supergivi/humidifier/README.md

# humidifier
Powerfull home humidifier with 30 liters tank  

[Фотки](https://github.com/supergivi/humidifier/tree/master/images)

Мне нужна нормальная влажность зимой. Иначе неприятно. И еще я люблю свежий воздух. Я перепробовал 3 разных увлажнителя за последние лет пять и с уверенностью заявляю, зимой в квартире которая нормально проветривается, невозможно удержать нормальную влажность с помщью того барахла, которое испаряет 350 мл в час. Не справляются ни один такой, ни вдвоем. Либо дома душно и влажность подбирается к приемлемым значениям, либо воздух свежий и влажность 9–15 процентов.
Решил сделать сам. Большой. Мощный. Емкий. С выносным датчиком влажности.
На алиэкспресс купил десятиголовый ультразвуковой излучатель с блоком питания.

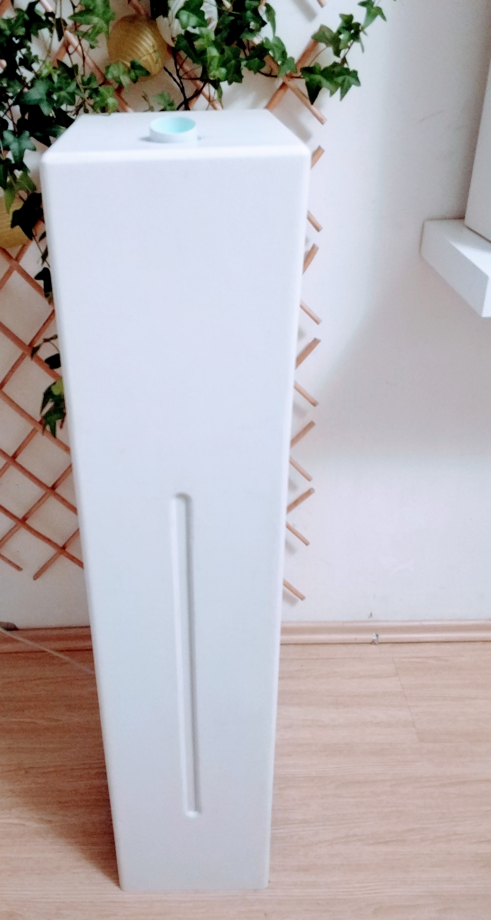
[picture p1: images/obchiy.jpg]
HUM


Корпус сделал из фанеры, с двумя герметичными камерами, соедененными пятисантиметровой канализационной трубой. Верхняя камера для излучателя, а нижняя для хранения воды. В самом низу, под нижней камерой расположил всю электронную начинку. А сверху верхней камеры провертел дыру для выхода пара. Все, что может касаться воды покрыл гидроизоляцией, подходящей для стоячей воды.
Вода заливается через через дырку для пара. Излучатель должен находиться под водой, поэтому труба выступает из дна верхней камеры на 7 сантиметров. Когда мы наливаем воду в увлажнитель, вся лишняя вода уходит в нижнюю камеру. Для контроля количества воды в нижней камере я сделал узкое, длиной во всю камеру смотровое окно из оргстекла. Обьем нижней камеры 30 литров. 

Со смотровым окном случился конфуз. Стекло, которое я применил, через пару дней использования решило потрескаться и стало пропускать воду. Выломал его нафиг, и на его место вклеил кусок пластика от кабель–канала. Стало совершенно неюзабельно в плане контроля количества воды, но за то герметично)

Для детектирования уровня воды в верхней камере использовал датчик уровня воды. При недостаточном уровне, насос перекачивает воду из нижней камеры в верхнюю. 
Датчик влажности сделал выносным. Болтается на двухметровом проводе.
В качестве платы управления использовал ардуину. Она запитана от блока питания, выломанного из старой зарядки на 12 вольт. Вентилятор и насос управляются ардуиной через драйвер, с помощью которого я могу плавно менять им обороты. Излучатель питается через свой 48 вольтовый блок питания. Управляю им тоже через ардуину, с помощью реле.
Почитав всякой литературы, понял, что опираться на относительную влажность будет не совсем правильно, потому что для 19 градусов оптимально больше 50%, а для 25 уже около 40%. А вот абсолютная влажность подходит хорошо. Остановился на 9 граммах на кубометр. Это 39% при 25 градусах, и 55% при 19 градусах. Очень похоже на кривую оптимальной влажности для разных температур, которую я нарыл в интернетах. Решил пересчитывать относительную влажность и температуру, приходящие с датчика в абсолютную влажность и управлять прибором исходя из нее.
Увлажнитель при необходимости готов испарить более полутора литров в час, и теперь невзирая на открытые форточки и погоду за окном у меня всегда оптимальная влажность) Вот! Ну и надо понимать, что это концепт. Когда я начинал его делать, у меня не было уверенности в том, что я хочу увидеть в итоге.
