supergivi/humidifier/images/blok-shema.jpg

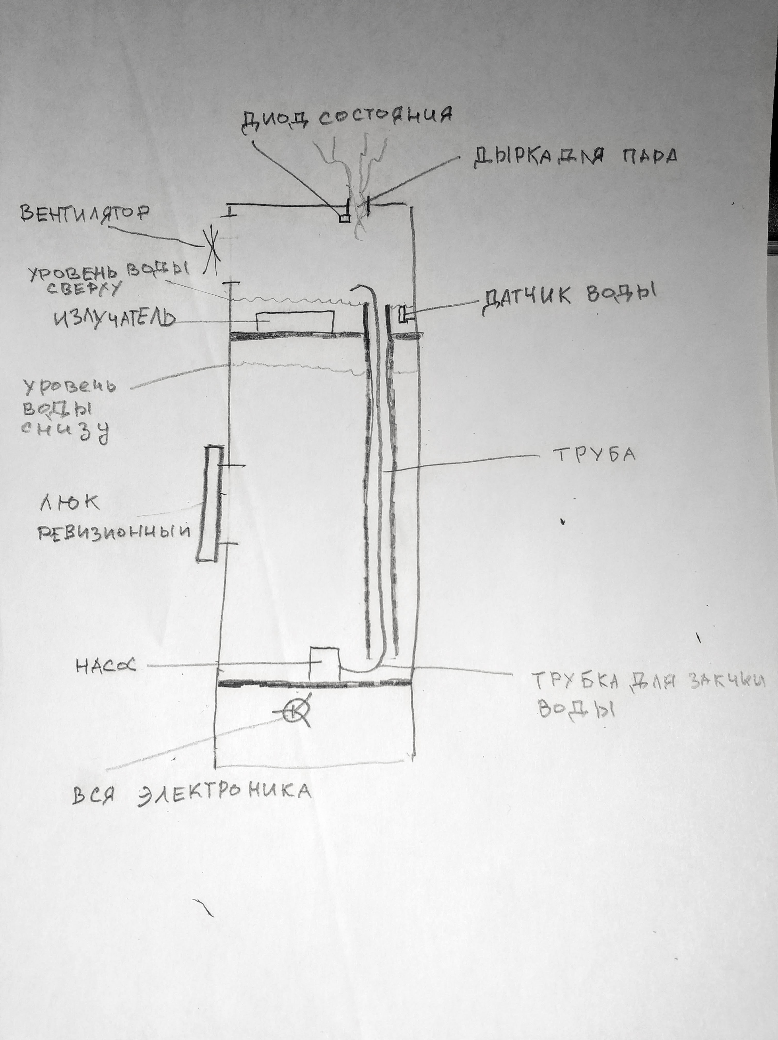
images/blok-shema.jpg
