supergivi/humidifier/images/datchik.jpg

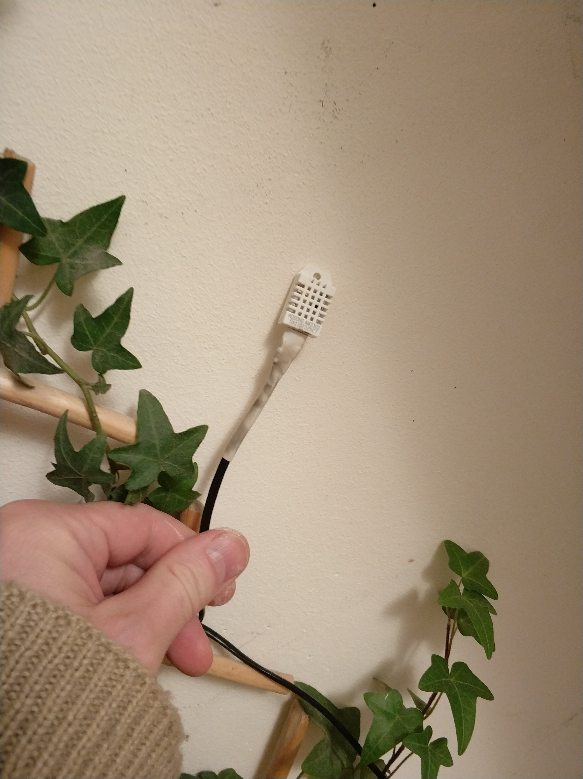
images/datchik.jpg
