supergivi/humidifier/images/dno_nijney_kamery.jpg

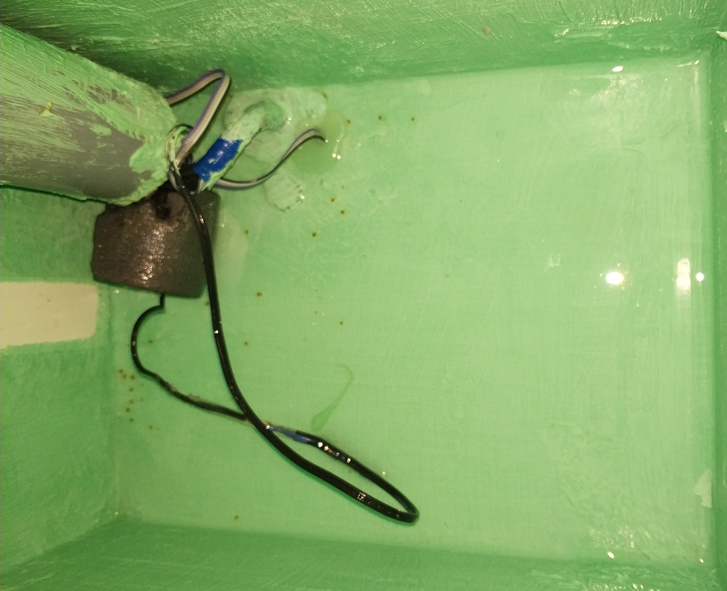
images/dno_nijney_kamery.jpg
