supergivi/humidifier/images/elektronika.jpg

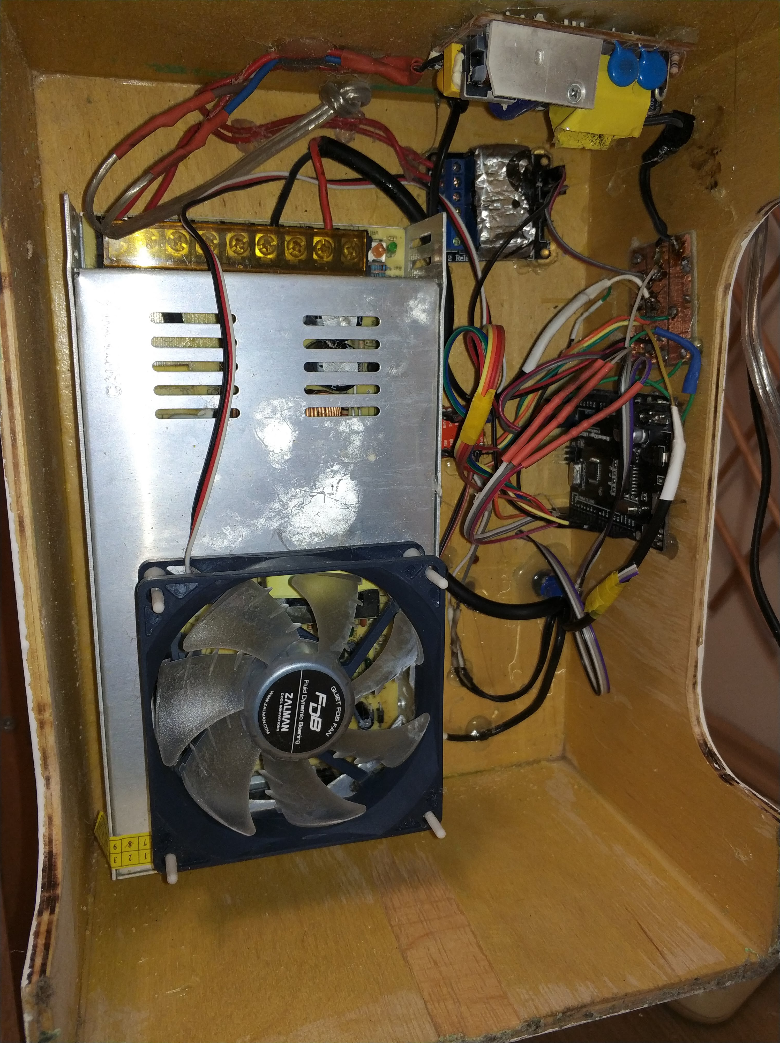
images/elektronika.jpg
