supergivi/humidifier/images/glaz2.jpg

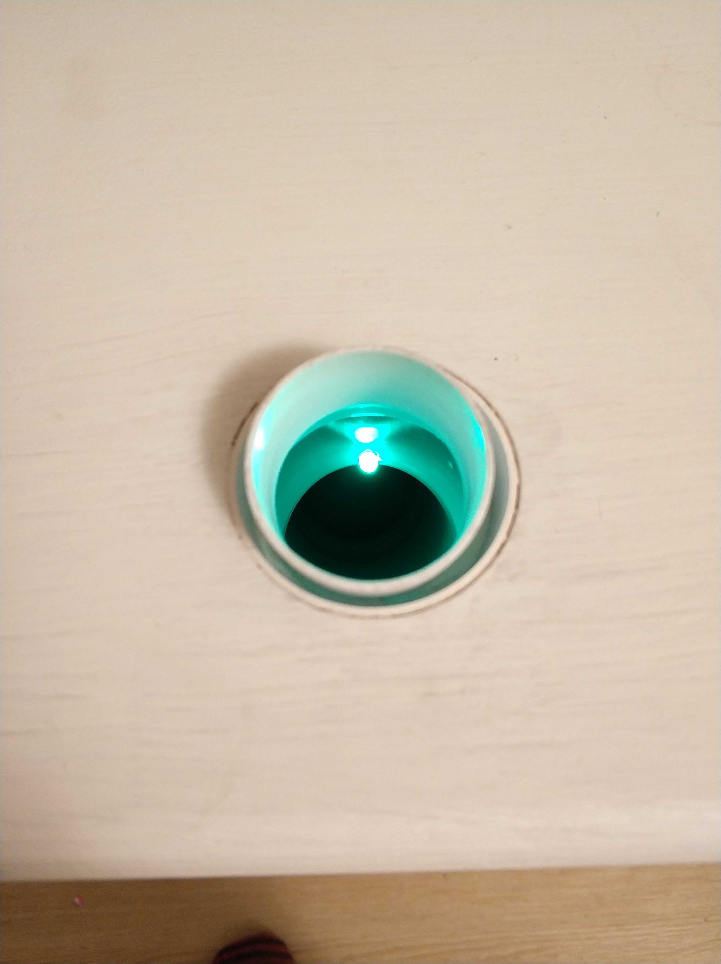
images/glaz2.jpg
