supergivi/humidifier/images/glaz.jpg

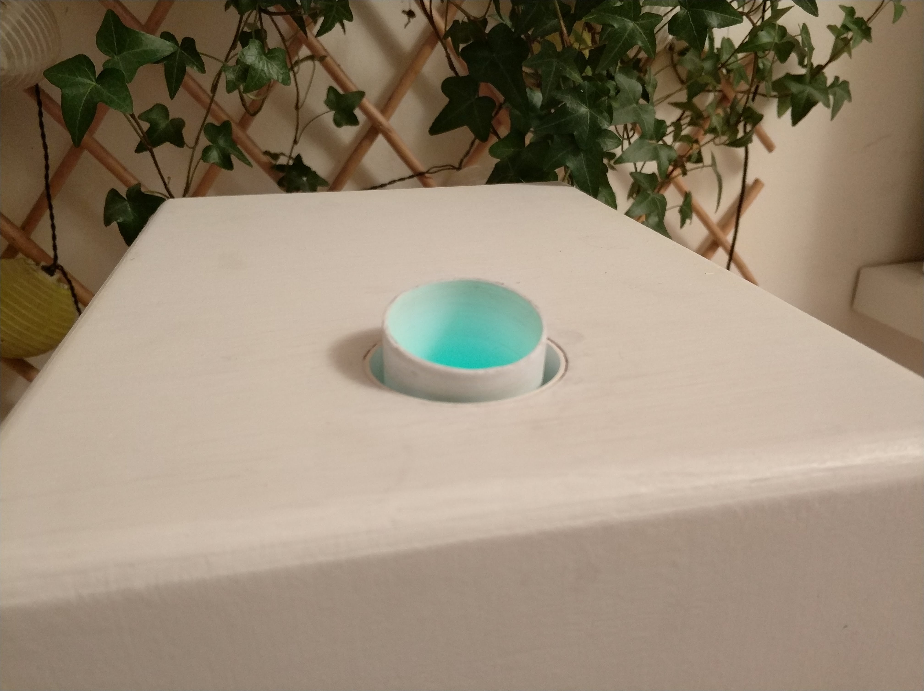
images/glaz.jpg
