supergivi/humidifier/images/pump.jpg

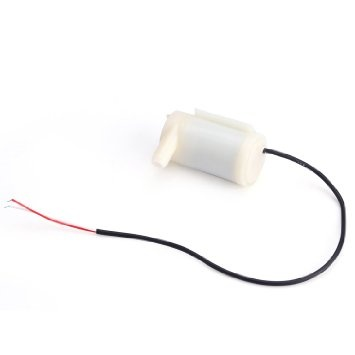
images/pump.jpg
