supergivi/humidifier/images/s_kotom.jpg

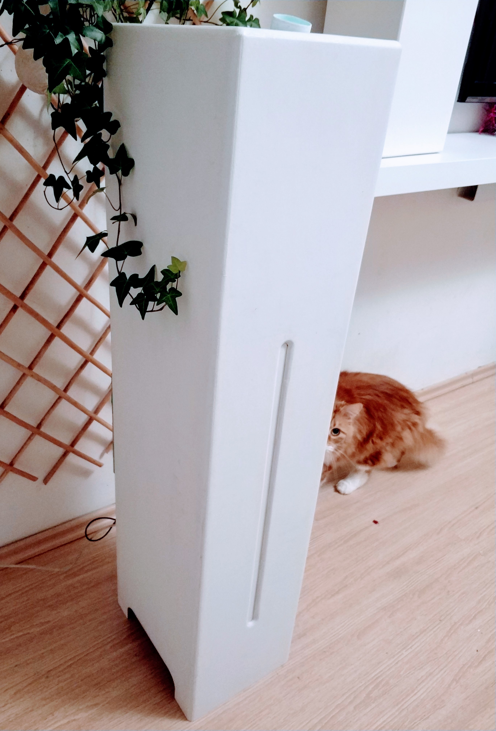
images/s_kotom.jpg
