supergivi/humidifier/images/sborka0.jpg

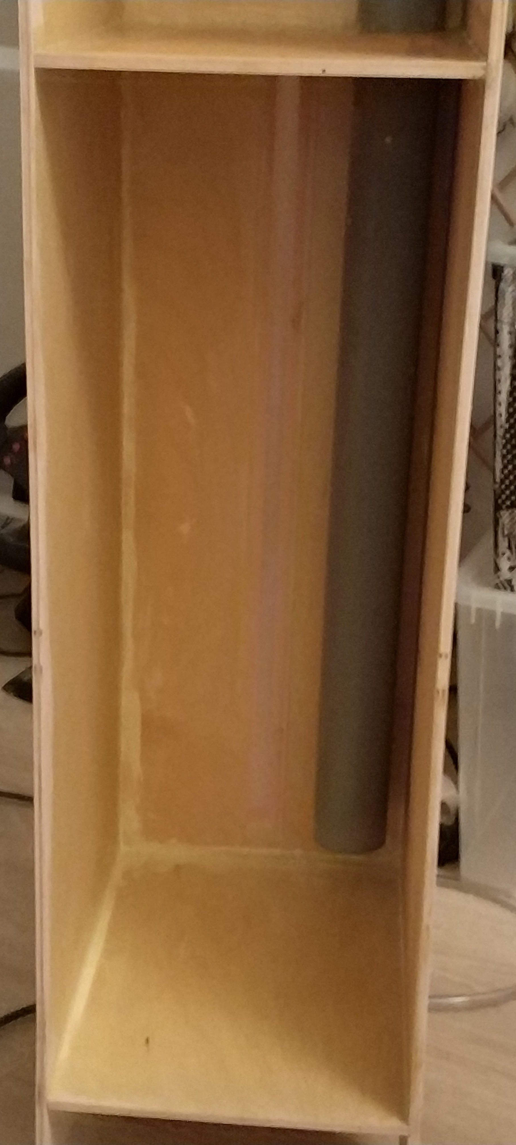
images/sborka0.jpg
