supergivi/humidifier/images/sborka1.jpg

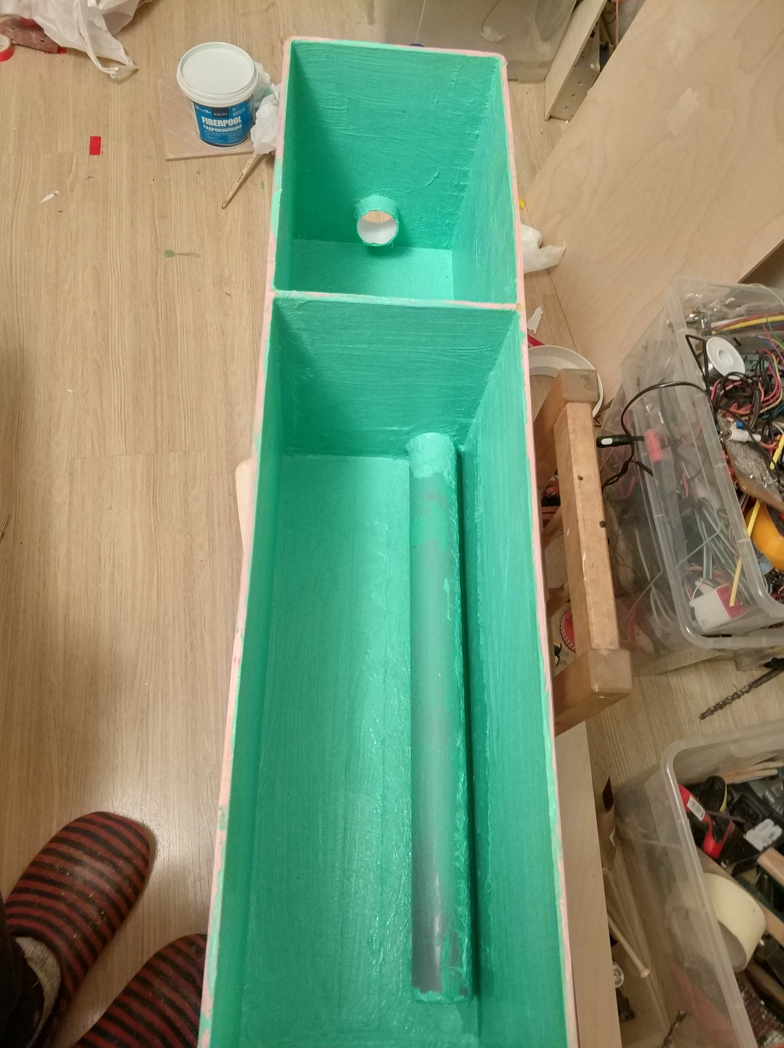
images/sborka1.jpg
