supergivi/humidifier/images/sborka2.jpg

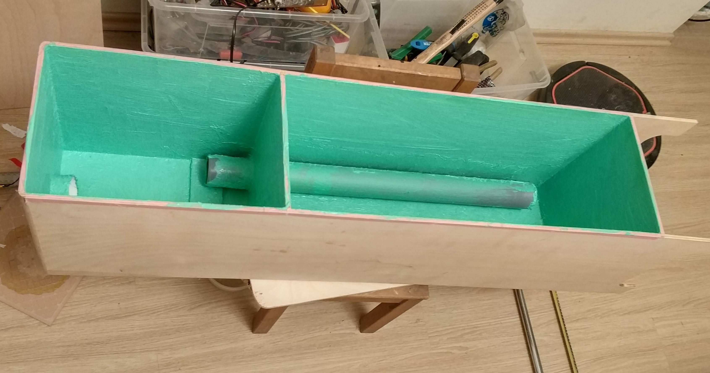
images/sborka2.jpg
