supergivi/humidifier/images/sborka-1.jpg

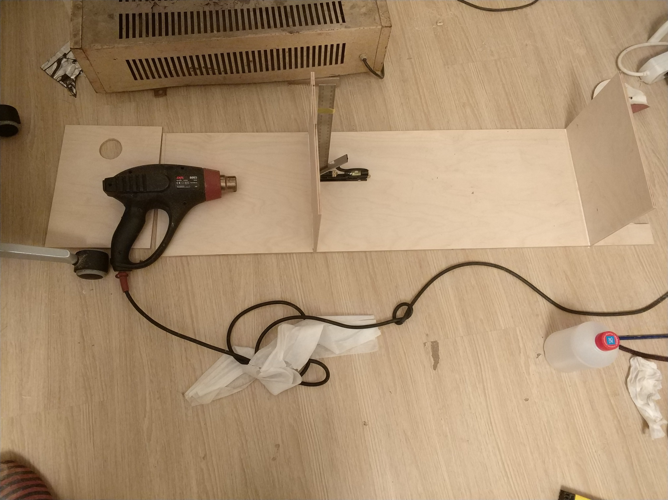
images/sborka-1.jpg
