supergivi/humidifier/images/sborka.jpg

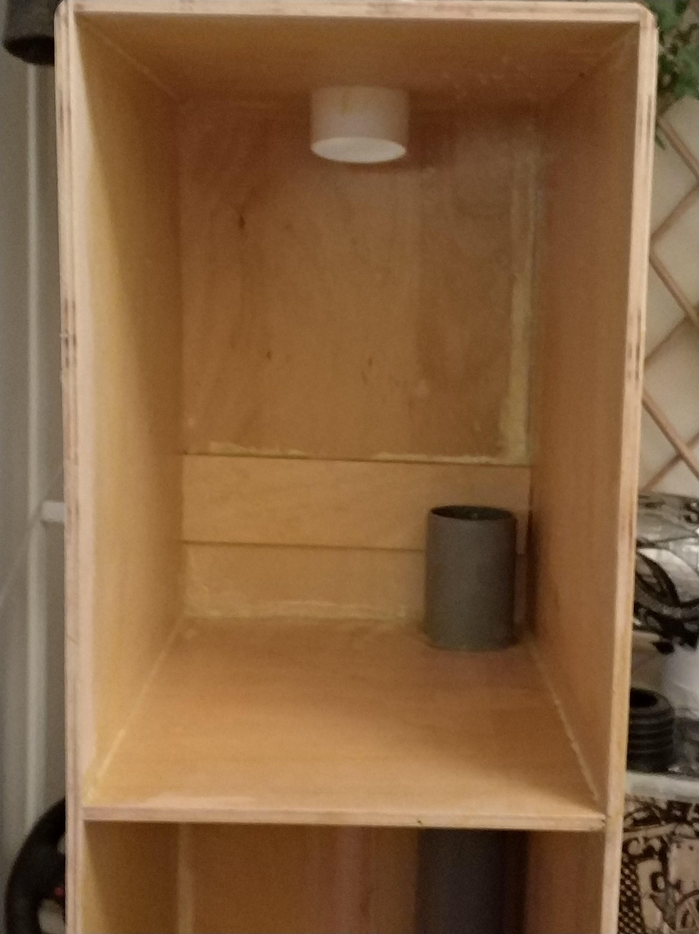
images/sborka.jpg
