supergivi/humidifier/images/szadi.jpg

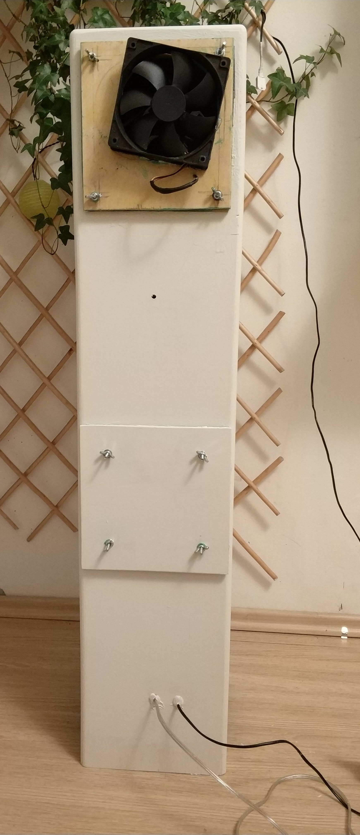
images/szadi.jpg
