supergivi/humidifier/images/ultrasonic.png

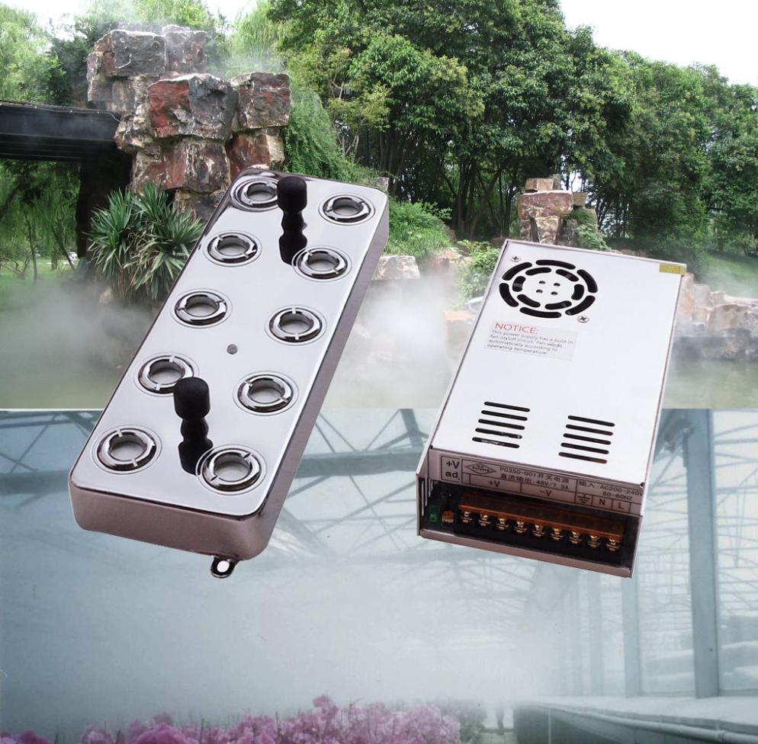
images/ultrasonic.png
