supergivi/humidifier/images/verhnyaa-kamera2.jpg

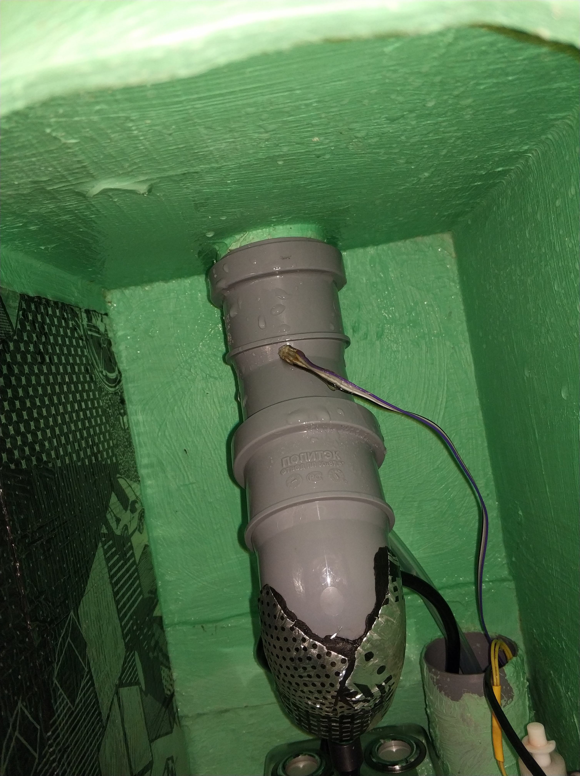
images/verhnyaa-kamera2.jpg
