supergivi/humidifier/images/verhnyaa_kamera1.jpg

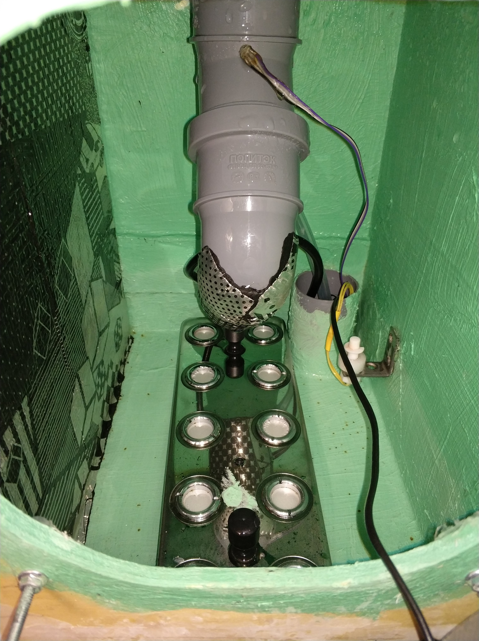
images/verhnyaa_kamera1.jpg
