supergivi/humidifier/(threads)

Thread 1 (2018-12-10):

зачем насос?

Qavai, 2018-12-10:
может быть лучше сделать самотеком?

бак с водой должен быть выше излучателя.

supergivi, 2018-12-11:
Если накопительный бак будет сверху, то непонятно, как его заправлять. Если сделать в нем дыру сверху, то из него все вытечет вниз.
